nickzu-ss/FUENTE-SIM-TRICA/3D.jpeg

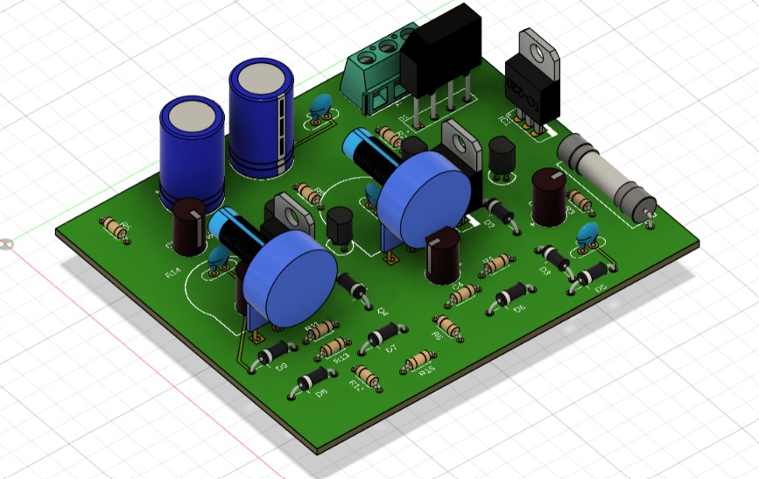
3D.jpeg
