nickzu-ss/FUENTE-SIM-TRICA/README.md

# FUENTE-SIM-TRICA
Diseño de una fuente de alimentación simétrica de ±15 V, con esquemas, archivos de diseño, simulaciones y documentación técnica.
