nickzu-ss/FUENTE-SIM-TRICA/protoboard_completa.png

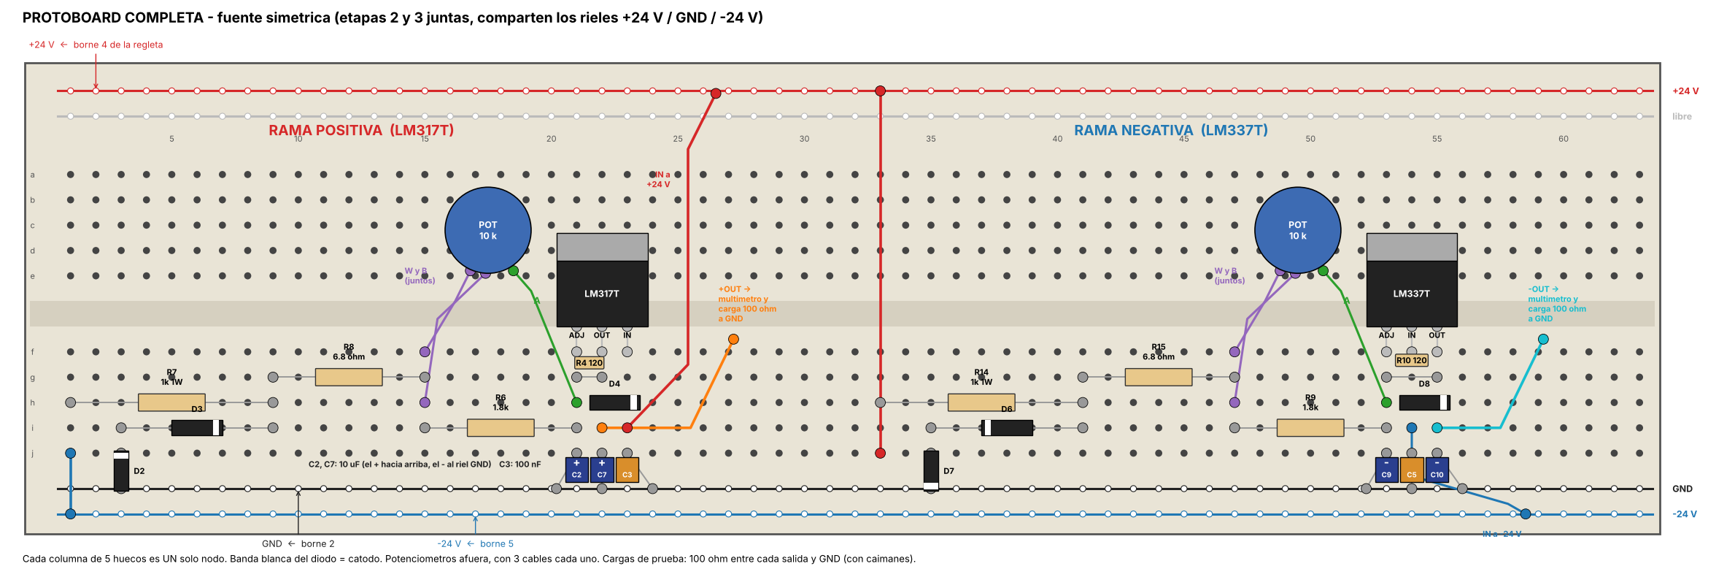
protoboard_completa.png
