nickzu-ss/FUENTE-SIM-TRICA/protoboard_etapa3_negativa.png

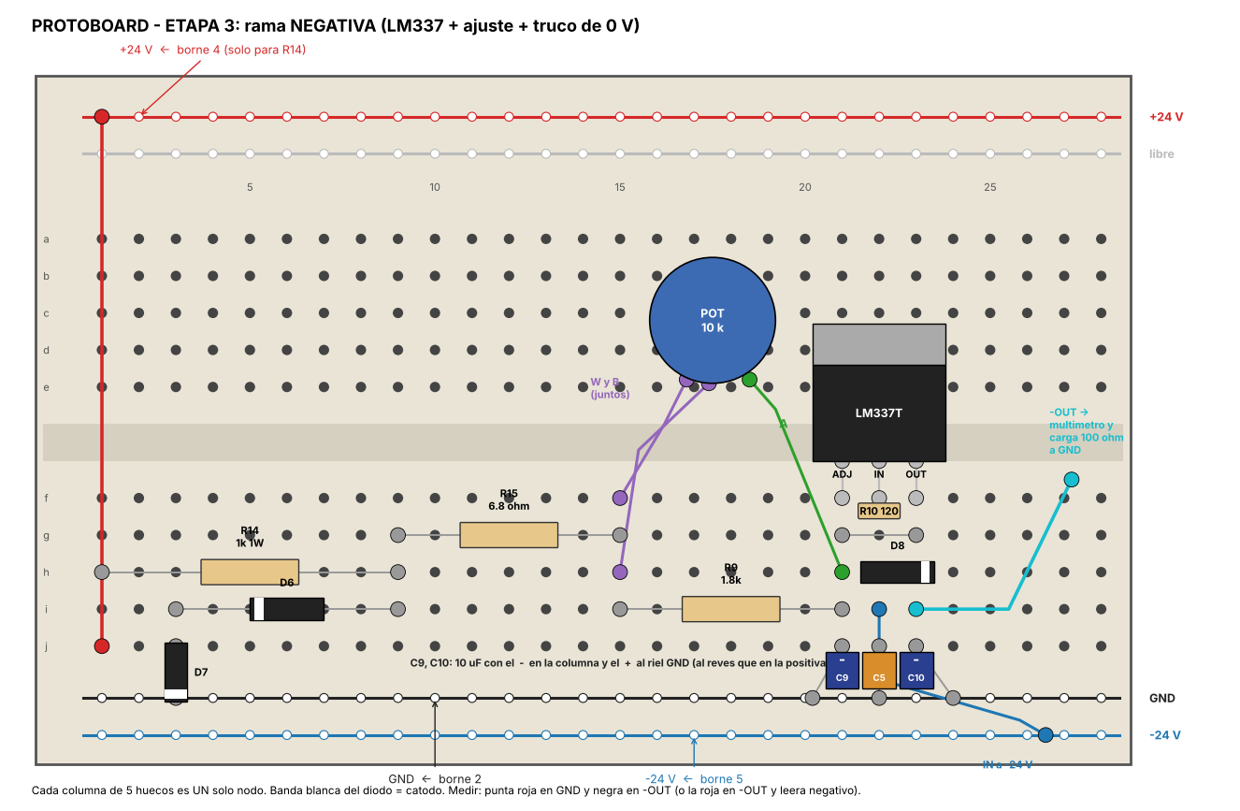
protoboard_etapa3_negativa.png
