nickzu-ss/FUENTE-SIM-TRICA/BOM_lista_de_compras.xlsx

Sheet: Lista de compras
Lista de compras: 2 fuentes simétricas regulables de 2 A (±1.25 V a ±15 V, con USB)
Cómo usarla: escribe el precio en las celdas amarillas de «Precio unit.»; el subtotal se calcula solo. Moneda: soles (S/).
Tipo: Base = necesario · Opcional = útil, no imprescindible · Alternativa = solo si no consigues la opción Base.
 |  |  |  | Fuentes iguales de 2 A a construir → |  | 2 | Las filas «2 A» se multiplican por este número.
Ejemplo: si el LM317T cuesta S/ 2.50, escribe 2.5 en su Precio unit.; con 2 fuentes el subtotal sale S/ 5.00.
N° | Fuente | Categoría | Ref. en esquema | Componente | Valor / modelo | Cant. por fuente | Cant. total | Tipo | Precio unit. (S/) | Subtotal (S/) | Notas
1 | 2 A | Semiconductores | U1 | Regulador positivo | LM317T (TO-220) | 1 |  | Base |  |  | En Multisim se usó el LM317K (TO-3). Alternos: LM350T, LM338T.
2 | 2 A | Semiconductores | U2 | Regulador negativo | LM337T (TO-220) | 1 |  | Base |  |  | Pinout distinto al LM317: ADJ – IN – OUT. Alterno: NTE957 (equivalente del LM337).
3 | 2 A | Semiconductores | Q1 | Transistor de paso (+) | MJ2955 (PNP, TO-3) | 1 |  | Base |  |  | Su carcasa es el colector (+OUT). Aislar del disipador con mica.
4 | 2 A | Semiconductores | Q3 | Transistor de paso (−) | 2N3055 (NPN, TO-3) | 1 |  | Base |  |  | Su carcasa es el colector (−OUT). Aislar del disipador con mica.
5 | 2 A | Semiconductores | QL+ | Limitador de corriente (+) | BD140 (PNP) | 1 |  | Base |  |  | En la simulación se usó el 2N2907 por falta del modelo.
6 | 2 A | Semiconductores | QL− | Limitador de corriente (−) | BD139 (NPN) | 1 |  | Base
7 | 2 A | Semiconductores | BR1 | Puente rectificador | KBPC1010 o KBU1010 (10 A) | 1 |  | Base |  |  | Mínimo 8 A / 200 V. En la simulación es el 1B4B42.
8 | 2 A | Semiconductores | D2–D9 | Diodos | 1N4007 | 10 |  | Base |  |  | 8 en uso (protección de reguladores y truco de 0 V) + 2 de repuesto.
9 | 2 A | Semiconductores | LED1, LED2 | LED indicadores (rojo y verde) | LED 5 mm | 2 |  | Opcional |  |  | Con una resistencia de 2.2 kΩ cada uno, de la salida a GND.
10 | 2 A | Resistencias | R1, R2 | Rsc: sensor del limitador | 0.27 Ω / 5 W | 2 |  | Base |  |  | Valor que hay en tienda: limita a ≈ 0.65 V / 0.27 Ω = 2.4 A. Levantarlas de la placa para que ventilen.
11 | 2 A | Resistencias | R3, R13 | Rb: polarización de la base | 3.3 Ω / 1 W | 2 |  | Base
12 | 2 A | Resistencias | R4, R10 | Red de ajuste (salida a ADJ) | 120 Ω / 1/4 W | 2 |  | Base |  |  | Mejor al 1 %.
13 | 2 A | Resistencias | R7, R14 | Para el nodo de 0 V | 1 kΩ / 1 W | 2 |  | Base |  |  | Del nodo N a la línea opuesta.
14 | 2 A | Resistencias | R6, R9 | Fija que define el máximo | 1.8 kΩ / 1/4 W | 2 |  | Base |  |  | En paralelo con el potenciómetro de 10 kΩ: máximo ≈ 15.8 V. Para 15.0 V exactos, poner 27 kΩ en paralelo con R6.
15 | 2 A | Resistencias | — | Resistencia para ajustar el máximo a 15.0 V | 27 kΩ / 1/4 W | 2 |  | Opcional |  |  | En paralelo con R6 / R9. Sin ella el máximo es ≈ 15.8 V.
16 | 2 A | Resistencias | R8, R15 | Para el nodo de 0 V | 6.8 Ω / 1/4 W (o 2 × 3.3 Ω en serie) | 2 |  | Base |  |  | Sin trimmers: el 0 V sale en ≈ ±0.0 a 0.1 V.
17 | 2 A | Resistencias | P1, P2 | Potenciómetros de ajuste (reóstato) | 10 kΩ lineal (B10K) | 2 |  | Base |  |  | Uno por rama; cable soldado a las patas: pata izquierda → ADJ, cursor + pata derecha → BP. Se igualan midiendo.
18 | 2 A | Resistencias | — | Perilla para potenciómetro | eje de 6 mm | 2 |  | Opcional
19 | 2 A | Capacitores | C1, C8 | Filtro principal | Electrolítico 4700 µF / 50 V | 2 |  | Base |  |  | En la simulación 10000 µF; 4700 µF alcanza para 2 A (rizado ≈ 3.5 V pico a pico).
20 | 2 A | Capacitores | C2, C9 | Cadj (en ADJ) | Electrolítico 10 µF / 35 V | 2 |  | Base |  |  | En la rama − el + va a GND.
21 | 2 A | Capacitores | C7, C10 | Cout (salida) | Electrolítico 10 µF / 35 V | 2 |  | Base |  |  | En la rama − el + va a GND.
22 | 2 A | Capacitores | C3, C4, C5, C6 | Cin y Cb (entrada y salida) | Cerámico 100 nF | 6 |  | Base |  |  | 4 en uso + 2 de repuesto.
23 | 2 A | USB | U4 | Módulo buck | LM2596 ajustable (5.1 V) | 1 |  | Base |  |  | Entra por la línea +. Ajustar a 5.1 V antes de conectar la placa.
24 | 2 A | USB | PTC1 | Fusible reseteable | PTC 1 A | 1 |  | Base |  |  | Un ESP32 con WiFi llega a ≈ 0.5 A.
25 | 2 A | USB | J1 | Conector USB-A hembra | con borneras | 1 |  | Base |  |  | Pin 4 a GND.
26 | 2 A | Enfriamiento | — | Disipador grande para TO-3 | ≤ 1.5 °C/W, con ventilador | 2 |  | Base |  |  | Cada transistor de paso llega a ≈ 46 W con la salida en 2 V y 2 A.
27 | 2 A | Enfriamiento | — | Disipador mediano TO-220 | para LM317T / LM337T | 2 |  | Base |  |  | El grueso de la potencia lo toma el transistor de paso.
28 | 2 A | Enfriamiento | — | Kit aislante TO-3 | mica + arandelas | 2 |  | Base |  |  | Obligatorio: +OUT y −OUT no deben tocarse a través del disipador.
29 | 2 A | Enfriamiento | — | Kit aislante TO-220 | mica + arandela | 2 |  | Base |  |  | La aleta del LM317T es OUT y la del LM337T es IN.
30 | 2 A | Enfriamiento | — | Pasta térmica | tubo | 1 |  | Base
31 | 2 A | Enfriamiento | FAN | Ventilador (opción A) | 24 V DC, 80–92 mm, 0.1–0.2 A | 1 |  | Base |  |  | Va entre la línea + (24 V) y GND.
32 | 2 A | Enfriamiento | FAN | Ventilador (opción B) | 12 V DC de PC | 1 |  | Alternativa |  |  | Solo si no hay de 24 V. Necesita el LM7812 y sus piezas.
33 | 2 A | Enfriamiento | U5 | Regulador para el ventilador B | LM7812 | 1 |  | Alternativa |  |  | IN a la línea +, COMMON a GND, OUT al ventilador.
34 | 2 A | Enfriamiento | — | Disipador pequeño TO-220 | para el LM7812 | 1 |  | Alternativa
35 | 2 A | Enfriamiento | — | Capacitor 330 nF | cerámico | 1 |  | Alternativa |  |  | A la entrada del LM7812.
36 | 2 A | Enfriamiento | — | Capacitor 100 nF | cerámico | 1 |  | Alternativa |  |  | A la salida del LM7812.
37 | 2 A | Protección | F1 | Fusible del primario | 1 A lento (T1A, 5×20 mm) | 1 |  | Base |  |  | Lento por la carga de los 4700 µF.
38 | 2 A | Protección | F2, F3 | Fusibles de línea | 3 A lentos (T3A, 5×20 mm) | 2 |  | Base |  |  | Uno en la línea + y otro en la línea − (puente a C1 y C8).
39 | 2 A | Protección | — | Portafusibles | 5×20 mm, para panel o placa | 3 |  | Base
40 | 2 A | Protección | — | Fusibles de salida | 2.5 A rápidos | 2 |  | Opcional |  |  | Cortan un cortocircuito en la salida.
41 | 2 A | Montaje | T1 | Transformador | 18+18 V, 4 A, primario 220 V | 1 |  | Base |  |  | Mínimo 3 A.
42 | 2 A | Montaje | — | Bornes banana | rojo, negro y azul | 3 |  | Base |  |  | +OUT, GND y −OUT.
43 | 2 A | Montaje | — | Interruptor general | con luz piloto | 1 |  | Base
44 | 2 A | Montaje | — | Cable con enchufe | 2 m | 1 |  | Base
45 | 2 A | Montaje | — | Caja / gabinete | metálico | 1 |  | Base |  |  | Si es metálico, conectarlo a tierra.
46 | 2 A | Montaje | — | Medidor de panel V/A | digital 0–30 V / 10 A | 2 |  | Opcional |  |  | Uno para +OUT y otro para −OUT.
47 | Común | PCB baquelita | — | Placa de baquelita virgen | fibra de vidrio (FR4), 1 cara, 15×20 cm | 2 |  | Base |  |  | Una por fuente. Pistas de potencia ≥ 2.5 mm.
48 | Común | PCB baquelita | — | Persulfato de sodio o cloruro férrico | para 1 L | 1 |  | Base
49 | Común | PCB baquelita | — | Papel de transferencia | glossy / fotográfico | 1 |  | Base |  |  | Planchado con tóner de impresora láser.
50 | Común | PCB baquelita | — | Alcohol isopropílico o acetona |  | 1 |  | Base |  |  | Para limpiar el cobre.
51 | Común | PCB baquelita | — | Lija fina | grano 600–1000 | 1 |  | Base
52 | Común | PCB baquelita | — | Brocas | 0.8 mm, 1 mm y 3 mm | 1 |  | Base |  |  | Juego de 3.
53 | Común | PCB baquelita | — | Minitaladro o Dremel |  | 1 |  | Opcional
54 | Común | PCB baquelita | — | Borneras de tornillo | 5.08 mm, 3 pines | 8 |  | Base |  |  | Trafo (3 hilos), transistores TO-3 (E, B, C), potenciómetros y medidores.
55 | Común | PCB baquelita | — | Borneras de tornillo | 5.08 mm, 2 pines | 4 |  | Base |  |  | Salidas ±OUT, GND, ventilador y USB.
56 | Común | Soldadura | — | Estaño 60/40 con flux | 0.8 mm | 1 |  | Base |  |  | También para reforzar pistas de potencia.
57 | Común | Soldadura | — | Flux en pasta |  | 1 |  | Opcional
58 | Común | Soldadura | — | Malla desoldante |  | 1 |  | Opcional
59 | Común | Cableado | — | Cable de 1.5 mm² | rojo, negro y azul, 3 m de cada uno | 1 |  | Base |  |  | Para los TO-3 y la potencia.
60 | Común | Cableado | — | Terminales ojal y faston | kit | 1 |  | Base
61 | Común | Cableado | — | Separadores y tornillos M3 | kit | 1 |  | Base
62 | Común | Cableado | — | Termocontraíble | kit | 1 |  | Opcional
63 | Pruebas | Arduino / ESP32 | — | Arduino Uno o Nano |  | 1 |  | Base |  |  | Carga de prueba de la salida USB.
64 | Pruebas | Arduino / ESP32 | — | ESP32 DevKit |  | 1 |  | Base |  |  | Pico de ≈ 0.5 A con WiFi: el PTC de 1 A alcanza.
65 | Pruebas | Arduino / ESP32 | — | Cable USB | A a micro-USB, USB-C o USB-B según la placa | 2 |  | Base
66 | Pruebas | Arduino / ESP32 | — | Protoboard y cables jumper |  | 1 |  | Opcional
67 | Pruebas | Pruebas de carga | — | Resistencia de potencia | 7.5 Ω / 50 W | 2 |  | Opcional |  |  | Para comprobar los 2 A: una por rama (15 V / 7.5 Ω = 2 A).
68 | Pruebas | Pruebas de carga | — | Foco de 60–100 W / 220 V con portalámpara |  | 1 |  | Opcional |  |  | En serie con el primario en el primer encendido, por seguridad.

Sheet: Resumen
Resumen de costos
Se llena solo cuando escribes los precios en «Lista de compras». Moneda: soles (S/).
Grupo | Base | Opcional | Alternativa | Base + Opcional | Qué incluye
2 A
Común
Pruebas
Total
Supuestos
Las dos fuentes son iguales: 2 A cada una, ±1.25 V a ±15 V (con el truco de 0 V, de 0 a ±15 V), con USB de 5 V en cada una.
Si el USB va solo en una fuente, quita los renglones de la categoría USB de la otra o baja su cantidad.
Los valores salen de la simulación en Multisim; los no comerciales se reemplazan por el valor de tienda más cercano (hoja «Simulación vs real»).
No incluye herramientas que ya tengas: soldador, multímetro, plancha, impresora láser.

Sheet: Simulación vs real
Valores de la simulación y qué comprar
Elemento | En Multisim | A comprar / montar | Por qué
Reguladores | LM317K / LM337K (TO-3) | LM317T / LM337T (TO-220) | Mismo comportamiento; el encapsulado T es el que se consigue.
Filtro C1 y C8 | 10000 µF / 50 V | 4700 µF / 50 V | Más fácil de conseguir; alcanza para 2 A (rizado ≈ 3.5 V pico a pico).
R6 y R9 (fija del máximo) | 5.02 kΩ (R6 = 5.0205 kΩ) | 1.8 kΩ en paralelo con pot de 10 kΩ | Con el reóstato de 10 kΩ el máximo es ≈ 15.8 V; 27 kΩ en paralelo con R6 lo deja en 15.0 V.
R8 y R15 (cero) | 7.3 Ω (R8 = 7.245 Ω) | 6.8 Ω (o 2 × 3.3 Ω en serie) | Valor comercial más cercano; el 0 V queda a décimas de voltio.
Potenciómetros P1 y P2 | 2 kΩ con tecla A | 10 kΩ lineal (B10K), uno por rama | Es el que hay en tienda; se usa como reóstato y se igualan midiendo.
Diodos | 1N4002 | 1N4007 | Es el mismo diodo, con más voltaje; es el más común.
Limitador (+) | 2N2907 | BD140 | El BD140 aguanta más corriente; en Multisim no había modelo.
Puente | 1B4B42 | KBPC1010 o KBU1010 | 10 A, con margen para 2 A por rama.
USB | LM7805CT + fusible + resistencia de 10 Ω | Módulo LM2596 + PTC 1 A + USB-A | El 7805 desde 24 V disiparía ≈ 9 W a 0.5 A.
Fusibles | No se simularon | T1A en el primario y T3A en cada línea | Lentos por la corriente de arranque de los 4700 µF.
Rsc | 0.33 Ω | 0.27 Ω / 5 W | Valor de tienda; límite ≈ 2.4 A.
Entrada | V1 = 220 V, 60 Hz; T1 = 220:18:18 | Trafo 18+18 V, 4 A | Cada secundario da 18 Vrms; la línea sin carga queda en ±24 V.
Carga de prueba | No hay | 7.5 Ω / 50 W | 15 V / 7.5 Ω = 2 A.

Sheet: Pruebas
Checklist de mediciones (en este orden)
Las celdas amarillas son para anotar lo que midas. Valores esperados tomados de la simulación en Multisim.
N° | Prueba | Dónde medir | Valor esperado | Resultado | ¿OK?
1 | Secundario del trafo | En AC, entre los dos extremos libres del secundario | ≈ 36 Vac
2 | Línea + sin reguladores | Línea + contra GND (en C1) | ≈ +24 V (23.86 V en la simulación)
3 | Línea − sin reguladores | Línea − contra GND (en C8) | ≈ −24 V
4 | +OUT con el pot al mínimo | +OUT contra GND | ≈ 0 V (a décimas de voltio)
5 | +OUT con el pot al máximo | +OUT contra GND | ≈ +15.8 V (15.0 V con 27 kΩ en paralelo con R6)
6 | −OUT con el pot al mínimo | −OUT contra GND | ≈ 0 V (a décimas de voltio)
7 | −OUT con el pot al máximo | −OUT contra GND | ≈ −15.8 V (−15.0 V con 27 kΩ en paralelo con R9)
8 | Simetría | |+OUT| − |−OUT| con los dos pots en el mismo valor | ≤ 0.3 V
9 | Carga de 2 A | 7.5 Ω de +OUT a GND, con la salida en 15 V | ≈ 15 V y ≈ 2 A
10 | Cortocircuito | 1 Ω en la salida, midiendo la corriente del transistor de paso | ≈ 2.4 A, sin subir
11 | USB | Salida del módulo LM2596 contra GND | 5.0 a 5.1 V
12 | USB con carga | Con el Arduino o el ESP32 conectado | 5 V estable, sin reinicios
13 | Ventilador | Entre la línea + y GND | Gira y mueve aire sobre los disipadores
14 | Temperatura | Disipadores tras 10 min a 2 A y 2 V de salida | Calientes pero sin pasar de ≈ 80 °C

Sheet: Notas PCB
Notas para armar la placa de baquelita
Tema | Recomendación
Pistas de potencia | ≥ 2.5 mm en las rutas de 2 a 3 A (puente → C1 y C8 → transistores de paso → salidas). El mínimo teórico para 3 A con +10 °C en cobre de 35 µm es ≈ 1.4 mm; se da margen por el grabado casero. Refuérzalas con estaño.
Pistas de señal | 0.8 a 1 mm para ADJ, trimmers y diodos.
Tierra | Un solo punto de GND en la toma central del trafo (B–C). A ese punto llegan los GND de C1 y C8, de las salidas y del USB.
Capacitores de 4700 µF | Pegados al puente, con pistas cortas y anchas.
Transistores TO-3 | Van en el disipador, fuera de la placa. Cablea E y B a bornera con cable de 1.5 mm². El colector es la carcasa.
Aislamiento | El colector de Q1 es +OUT y el de Q3 es −OUT. Si comparten disipador, usa mica y arandelas aislantes, o disipadores separados.
LM317T y LM337T | La aleta del LM317T es OUT (+OUT) y la del LM337T es IN (línea −). Aíslalas si comparten disipador.
Polaridad de los electrolíticos | En la rama −, el + de C8, C9 y C10 va a GND. En la rama +, el + va al lado positivo.
Resistencias de 5 W (Rsc) | Levantadas 5 a 10 mm de la placa. A 2 A disipan ≈ 1.3 W.
Potenciómetros | Van en el panel; cable soldado a las patas hacia JP1/JP2 de la placa.
Primario de 220 V | Pistas separadas ≥ 3 mm del resto, o cablea el primario fuera de la placa. Fusible T1A antes del trafo.
Primer encendido | Con un foco de 60 a 100 W en serie con el primario: si el foco brilla fuerte, hay un cortocircuito.
Orden de pruebas | Sigue la hoja «Pruebas»: primero ±24 V sin reguladores, luego los reguladores sin carga, y al final la carga y el cortocircuito.
