nickzu-ss/FUENTE-SIM-TRICA/pcb_ubicacion_componentes.png

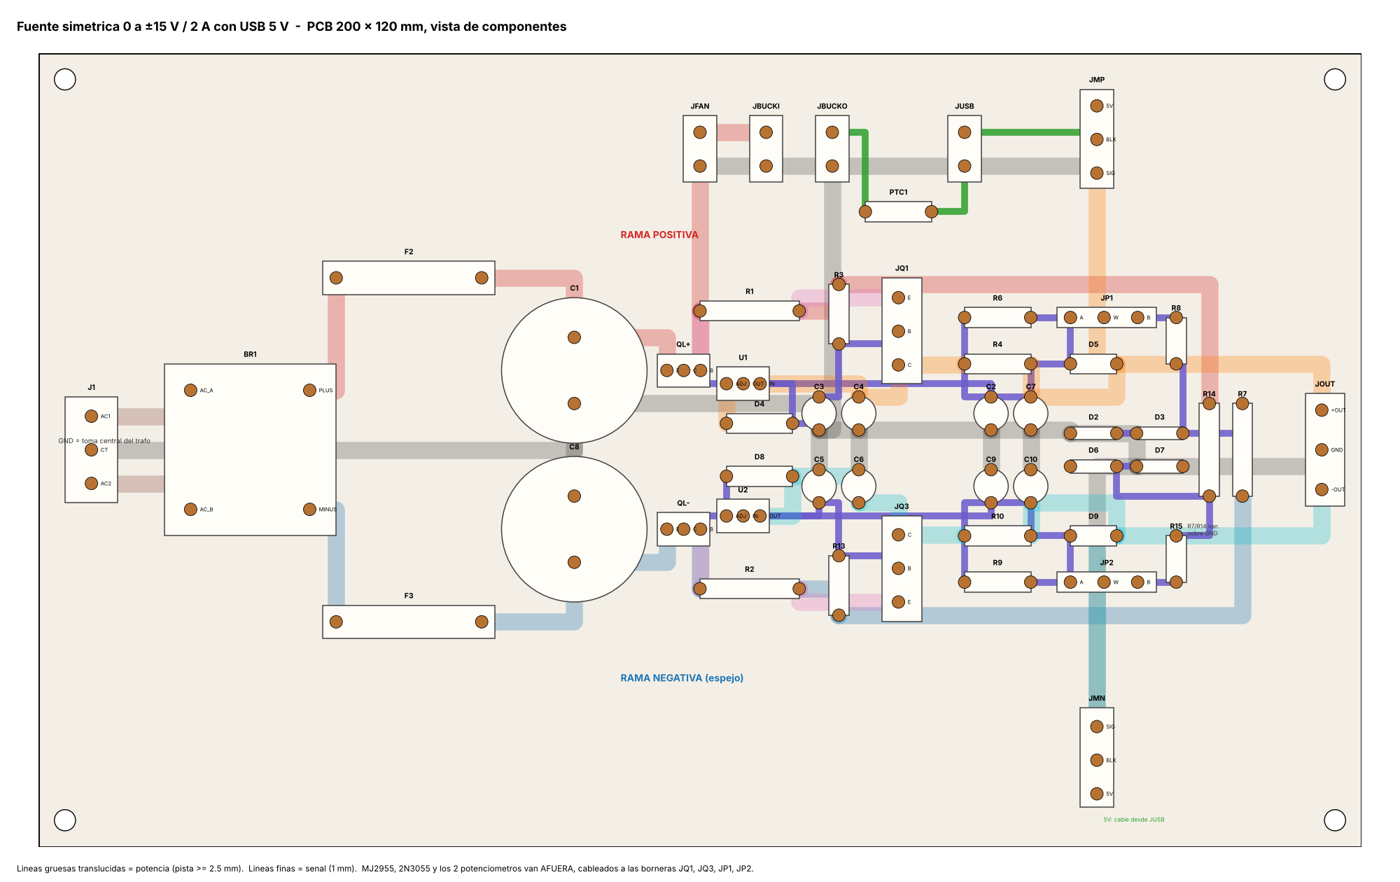
pcb_ubicacion_componentes.png
