nickzu-ss/FUENTE-SIM-TRICA/3D PLACA.stl

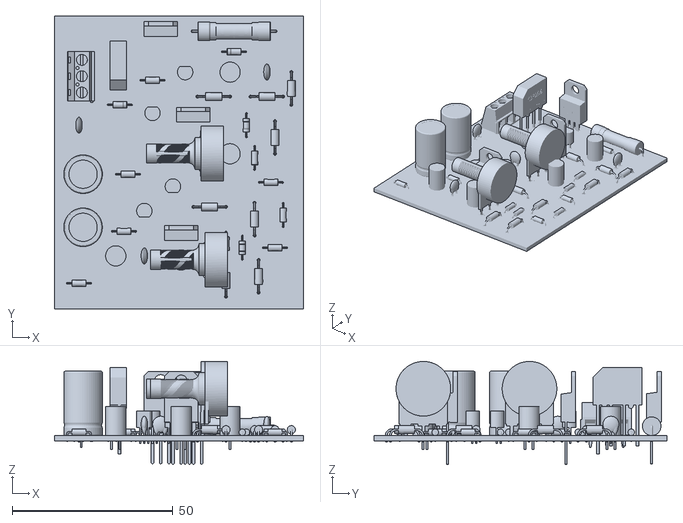
[picture p5: CAD file, 2026-11-07]
3D PLACA.stl
77.5 x 91.1 x 32.1
