nickzu-ss/FUENTE-SIM-TRICA/(list of files, drawings)

Other design files:
FUENTE SIMETRICA SIMU.ms14
