nickzu-ss/FUENTE-SIM-TRICA/Placa 1.1.1}.brd

## EAGLE design Placa 1.1.1}.brd (2026-11-07)

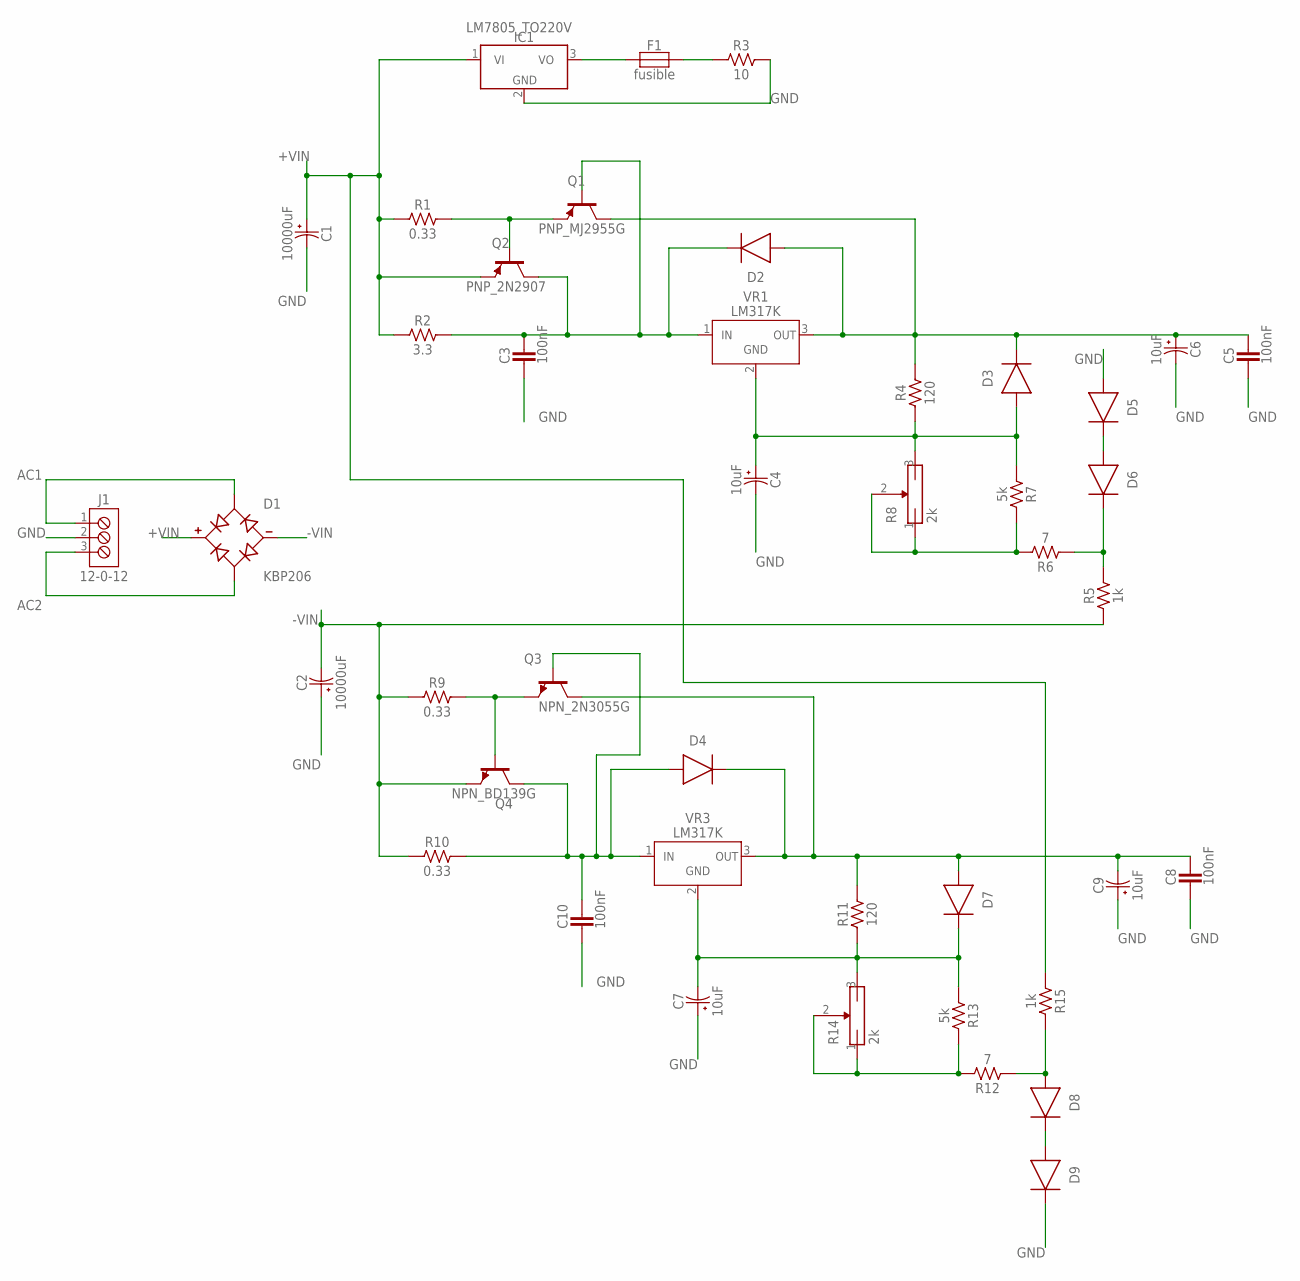
[picture p6: schematic Placa 1.1.sch]

Parts:
C1, C2: 10000uF; CAPPRD550W60D1200H2000B
C3, C5, C8, C10: 100nF; CAP-THRU-2.54MM
C4, C6, C7, C9: 10uF; CAPPRD250W80D630H800B
D1: KBP206; SIP380W81P386L1470H1270Q4
D2, D3, D4, D5, D6, D7, D8, D9: DIODEDIODE-AXIAL; DIODE-AXIAL
F1: fusible; FUSAD2590W70L2150D550B
IC1: LM7805_TO220V; TO220V
J1: 12-0-12; TERMBLK_508-3N
Q1: PNP_MJ2955G; TO92
Q2: PNP_2N2907; TO92
Q3: NPN_2N3055G; TO92
Q4: NPN_BD139G; TO92
R1, R9, R10: 0.33; RESAD724W46L381D178B
R2: 3.3; RESAD724W46L381D178B
R3: 10; RESAD724W46L381D178B
R4, R11: 120; RESAD724W46L381D178B
R5, R15: 1k; RESAD724W46L381D178B
R6, R12: 7; RESAD724W46L381D178B
R7, R13: 5k; RESAD724W46L381D178B
R8, R14: 2k; WH148-5.0
VR1, VR3: LM317K; TO220V

Connections:
+VIN: C1.1 (+), D1.1 (+), IC1.1 (VI), Q2.3 (E), R1.1, R2.1, R15.1
-VIN: C2.2 (-), D1.4 (-), Q4.1 (E), R5.1, R9.1, R10.1
AC1: D1.2 (AC1), J1.1
AC2: D1.3 (AC2), J1.3
GND: C1.2 (-), C2.1 (+), C3.2, C4.2 (-), C5.2, C6.2 (-), C7.1 (+), C8.2, C9.1 (+), C10.2, D5.1 (A), D9.2 (C), IC1.2 (GND), J1.2, R3.2
unnamed: C5.1, C6.1 (+), D2.1 (A), D3.2 (C), Q1.1 (C), R4.2, VR1.3 (VO)
unnamed: R6.2, R7.2, R8.1, R8.2 (W)
unnamed: Q1.3 (E), Q2.2 (B), R1.2
unnamed: C3.1, D2.2 (C), Q1.2 (B), Q2.1 (C), R2.2, VR1.1 (VI)
unnamed: C4.1 (+), D3.1 (A), R4.1, R7.1, R8.3, VR1.2 (GND)
unnamed: F1.1, IC1.3 (VO)
unnamed: D5.2 (C), D6.1 (A)
unnamed: D6.2 (C), R5.2, R6.1
unnamed: F1.2, R3.1
unnamed: Q3.1 (E), Q4.2 (B), R9.2
unnamed: C8.1, C9.2 (-), D4.2 (C), D7.1 (A), Q3.3 (C), R11.2, VR3.3 (VO)
unnamed: C10.1, D4.1 (A), Q3.2 (B), Q4.3 (C), R10.2, VR3.1 (VI)
unnamed: C7.2 (-), D7.2 (C), R11.1, R13.1, R14.3, VR3.2 (GND)
unnamed: R12.2, R13.2, R14.1, R14.2 (W)
unnamed: D8.2 (C), D9.1 (A)
unnamed: D8.1 (A), R12.1, R15.2

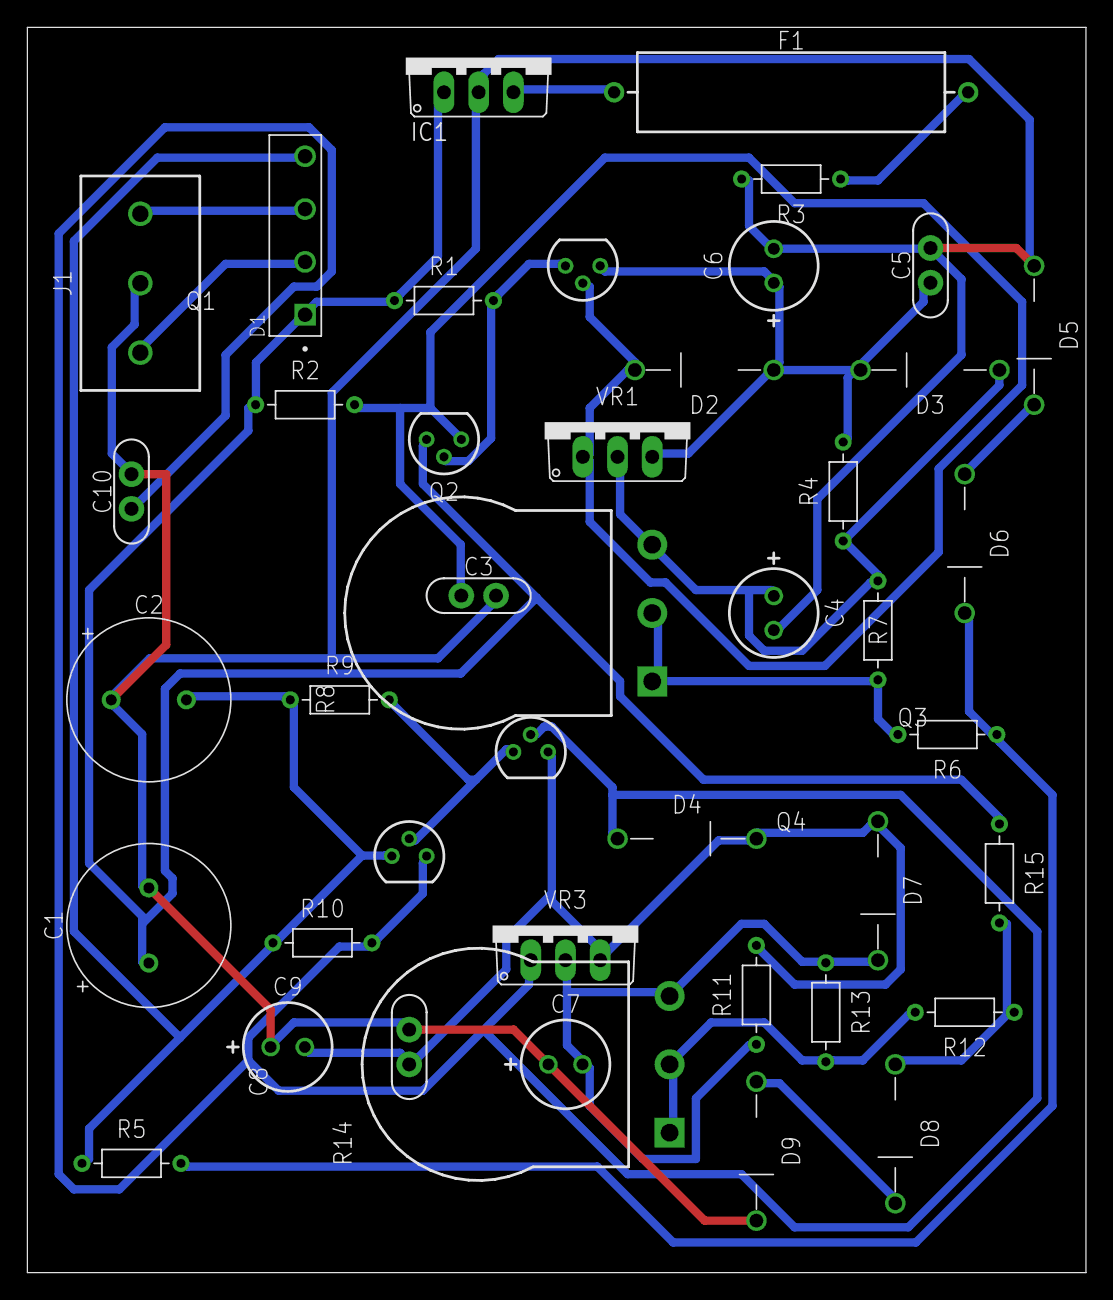
[picture p7: board Placa 1.1.1}.brd from above]

Board: 2 copper layers, 77.5 x 91.1 mm, 43 parts (0 on the bottom side), 21 nets.
